vcampos4545/pen-plotter/README.md

# Pen Plotter

A local web app for sketching on a 2-axis pen plotter and sending the drawing to it
over WiFi. The plotter is an ESP32 running [FluidNC](https://github.com/bdring/FluidNC):
one NEMA 17 moves the paper tray, one moves the pen, and an MG90S servo on the Z axis
lifts the pen. The browser talks to FluidNC's WebSocket directly. Nothing is hosted
on the ESP32.

The controller's FluidNC `config.yaml`, wiring and first power-on steps are in
[firmware/README.md](firmware/README.md).

## Repository layout

- `src/`, `test/`, `sim/`, `index.html`: the web app, its tests and the FluidNC simulator.
- [`firmware/`](firmware/): FluidNC `config.yaml`, wiring and first power-on.
- [`hardware/`](hardware/): CAD source, printable STLs, KiCad project and fab orders.
- [`docs/`](docs/): bill of materials, wiring photos, assembly notes.

## Run it

Needs Node 20 or newer.

```sh
npm install
npm run dev        # serves the app at http://localhost:5173
npm test           # unit + simulator integration tests (Vitest)
npm run build      # typecheck and production build into dist/
```

## Using the app

- **Tools**: Pen (freehand), Line, Rect, Ellipse, Eraser (deletes a whole stroke),
  Undo/Redo, Clear. Shortcuts: `P` `L` `R` `O` `E`, Ctrl/Cmd+Z, Ctrl/Cmd+Shift+Z.
  Hold Shift for a square, a circle, or a line snapped to 15°.
- The sheet is drawn at its real aspect ratio. The dashed box is the margin; points
  are clamped to it while drawing. The red dot marks machine X0 Y0.
- The drawing is saved in localStorage on every change. Use **SVG** / **JSON** to
  export and **Import** to load them back. SVG import accepts `polyline`, `polygon`,
  `line` and straight-segment `path` elements; curves are rejected.
- **Topo** opens a world map for drawing contour lines or ridgelines of real terrain.
  See [Topo lines](#topo-lines) and [Ridgelines](#ridgelines) below.
- **Photo** turns a photo into lines: squiggles, a spiral, hatching, outlines or TSP
  art. See [Photo to lines](#photo-to-lines) below. Dropping a photo on the sheet
  opens it too.
- **Streets** draws roads, rivers and coastlines from OpenStreetMap for a box on the
  map. See [Street maps](#street-maps) below.
- **Generate** makes math art: spirographs, harmonographs, strange attractors, flow
  fields and mazes. See [Generate](#generate) below.
- **Text** draws lettering in single-stroke or outline fonts, filled, bent and
  shadowed. See [Text](#text) below.
- **Send to Plotter** runs flatten → simplify → optimize → G-code → stream. It is
  disabled unless the indicator says Connected and the drawing is inside the margin.
  **Download G-code** saves the same program to a file.
- The stats panel shows pen-up travel as drawn vs. after optimization. Tick
  **Show pen-up moves** to overlay the planned travel in red.
- **Job** shows lines sent and acknowledged and a percentage, with Pause, Resume and Stop.
- **Machine** has Unlock (`$X`), Pen up/down, To origin, Set origin, and a console for
  one-off commands. These are disabled while a job runs.
- **Set origin** makes the pen's current spot X0 Y0, after a confirmation. It clears the
  work offsets and runs `$H`, which with this repo's `config.yaml` sets the machine
  position of X and Y to 0 without moving (homing `cycle: -1`) and lifts the pen. The
  travel limits then count from the new origin too. With an older `config.yaml` it falls
  back to a work offset (`G10 L20`) and says how much of the travel window is left; see
  [firmware/README.md](firmware/README.md#set-origin).

### Topo lines

1. Press **Topo**. Pan and zoom the map to a place.
2. Press **Select area** (or hold Shift) and drag a box. The elevation for the box
   downloads and the contours appear in the preview on the right, in blue on top of
   the current drawing.
3. Adjust the controls. The preview updates without downloading again. **Style**
   switches between contour lines and [ridgelines](#ridgelines) on the same area.
   - **Contours**: a line every N metres, or N evenly spaced levels. When a new area
     would get fewer than 3 or more than 250 lines at the current interval, the
     interval is reset to a round number giving about 20.
   - **Smoothing**: blur passes over the elevation before contouring. More passes give
     calmer lines and fewer tiny loops.
   - **Simplify**: point reduction tolerance on the paper, in mm.
   - **Drop lines shorter than**: fragments below this length on the paper are left out
     so the plotter does not spend time on noise.
4. Press **Add to drawing**. The contours become ordinary strokes, added as one undo
   step, so undo, export, the planner, stats and Send treat them like anything drawn
   by hand.

Under the controls the dialog shows the elevation range, the line and point count, the
pen-down and pen-up distance and an estimate of the drawing time at the current feeds.

**Match paper shape** (on by default) locks the box to the shape of the drawable area,
measured on the ground, so the contours fill the sheet. Turn it off to select any
shape. The contours are always fitted inside the margin at the box's true proportions:
east-west distance is scaled by the cosine of the box's middle latitude, so a box far
from the equator is not stretched sideways. Large or very wide boxes leave unused paper
when the lock is off.

Elevation comes from the [AWS Terrain Tiles](https://registry.opendata.aws/terrain-tiles/)
(Terrarium PNG tiles, no key needed). The zoom level is chosen so the box's longer side
covers at least 400 source pixels, capped at 16 tiles per box and zoom 15. The elevation
is resampled to a grid of 300 samples on the box's longer side and contoured with
marching squares. A Topo session needs an internet connection; a failed download says
which tile failed and offers **Retry download**. An area with no contours at the chosen
settings (flat ground, or an interval larger than the elevation range) says so instead
of adding nothing silently.

The tested parts are `src/terrain.ts` (tile math, Terrarium decoding, stitching,
resampling, the aspect lock), `src/contour.ts` (smoothing, levels, marching squares)
and `src/topo.ts` (fitting to the paper and dropping fragments). `src/topo-ui.ts` is the
dialog and map wiring and loads only when **Topo** is first opened.

**Attribution.** The map's corner credits OpenStreetMap and the Terrain Tiles, and
**Elevation data sources** under the dialog's buttons holds the full terrain credit:

- Map tiles and data © [OpenStreetMap](https://www.openstreetmap.org/copyright)
  contributors.
- Elevation from the Terrain Tiles. Their
  [required attribution](https://github.com/tilezen/joerd/blob/master/docs/attribution.md)
  is: ArcticDEM terrain data DEM(s) were created from DigitalGlobe, Inc., imagery and
  funded under National Science Foundation awards 1043681, 1559691, and 1542736;
  Australia terrain data © Commonwealth of Australia (Geoscience Australia) 2017;
  Austria terrain data © offene Daten Österreichs, Digitales Geländemodell (DGM)
  Österreich; Canada terrain data contains information licensed under the Open
  Government Licence, Canada; Europe terrain data produced using Copernicus data and
  information funded by the European Union, EU-DEM layers; Global ETOPO1 terrain data
  U.S. National Oceanic and Atmospheric Administration; Mexico terrain data source:
  INEGI, Continental relief, 2016; New Zealand terrain data Copyright 2011 Crown
  copyright (c) Land Information New Zealand and the New Zealand Government (All rights
  reserved); Norway terrain data © Kartverket; United Kingdom terrain data ©
  Environment Agency copyright and/or database right 2015. All rights reserved; United
  States 3DEP (formerly NED) and global GMTED2010 and SRTM terrain data courtesy of the
  U.S. Geological Survey.

The map tiles come from `tile.openstreetmap.org`, which is fine for this kind of light
personal use under the [tile usage policy](https://operations.osmfoundation.org/policies/tiles/).

### Ridgelines

Stacked horizontal elevation profiles, like the *Unknown Pleasures* album cover but made
of real mountains.

1. Press **Topo**, select an area as for [Topo lines](#topo-lines), and set **Style** to
   **Ridgelines**. A box around one massif or a single valley reads best.
2. Adjust the controls. The preview updates live.
   - **Number of lines**: profiles drawn across the area, evenly spaced from its north
     edge (the back, at the top of the sheet) to its south edge (the front). 2 to 300,
     default 60.
   - **Height (line gaps)**: how far the highest point in the area rises above its own
     line, measured in gaps between lines. The status line shows what that means
     against the real ground, e.g. "heights about ×1.2 true scale".
   - **Flat baseline at the sides**: fades each profile down to a flat line over the
     outer 15% of the width on each side, for the album-cover look. Off, the profiles
     run edge to edge at their true elevation.
   - **Smoothing**, **Simplify** and **Drop lines shorter than** work as for contours;
     each style remembers its own values.
3. Press **Add to drawing**.

Hidden lines are removed: the profiles are drawn from the front of the area to the
back, and each one is cut where it passes behind the skyline of the rows in front of
it, so lines touch but never cross. A cut profile becomes separate strokes. Every
profile shares one horizontal scale, set by the box's ground width, so the map's
proportions hold across the sheet; the rows and the peaks of the back row are fitted
inside the margin together, which leaves a little unused paper at the sides when
**Match paper shape** is on. Simplify can move a line by up to its tolerance, so keep
it small.

The elevation is the same Terrain Tiles data as Topo lines, with the same attribution
(see above). The tested part is `src/ridgeline.ts` (layout, sampling, the skyline clip
and the options).

### Photo to lines

1. Press **Photo**, then **Choose photo…** or drop a JPEG, PNG or WebP on the dialog
   (or on the sheet). The image is decoded in the browser and never uploaded.
2. Pick a **Style** and **Framing**. **Crop to fill** cuts the photo to the shape of
   the drawable area so the lines fill the sheet; **Fit whole photo** keeps all of it
   and leaves margins. The thumbnail shows the photo as the generator sees it.
3. Adjust **Brightness**, **Contrast** and **Gamma** (above 1 lightens mid-tones), or
   tick **Invert**. Then tune the style:
   - **Squiggle lines**: rows across the sheet whose wave grows taller and tighter
     where the photo is darker. *Rows*, *Max amplitude* (× the row gap; 0.5 lets
     neighbouring rows touch) and *Frequency* (waves per mm at full black).
   - **Spiral**: one line from the centre out to the largest circle that fits, with a
     radial wobble in dark areas. The pen never lifts. *Ring spacing*, *Max amplitude*
     (× spacing) and *Frequency*.
   - **Hatching**: straight lines at *Line spacing* and *Angle*. Each of the 1 to 4
     *Layers* adds a direction (+90°, +45°, −45°) where the photo is darker than its
     threshold (evenly spaced, e.g. 25%, 50%, 75% for three layers).
   - **Outline**: Canny-style edge detection (blur, Sobel, thin edges, hysteresis)
     traced into lines. *Smoothing* blurs first, a higher *Edge threshold* keeps only
     strong edges, and *Drop lines shorter than* removes specks.
   - **TSP art**: *Points* stipples placed by darkness (weighted Lloyd relaxation),
     joined into one continuous path by a nearest-neighbour tour improved with 2-opt.
     *Time limit* caps stippling plus path optimization.
4. The preview shows the lines in blue on the sheet, with the line count, points,
   pen-down length, an approximate pen-up distance and draw time. A warning appears
   for jobs over 2 hours, drawings too big to autosave (over 200,000 points: export
   JSON to keep them) and more than 8,000 separate lines (slow path planning).
5. Press **Add to drawing**. The lines become ordinary strokes, added as one undo step.

Lines are generated in a Web Worker, so the dialog stays responsive while TSP runs.
The photo is scaled to at most 640 pixels on its longer side for processing. The
settings are remembered; the photo is not. The tested parts are `src/tone.ts`
(luminance, tone adjustments, sampling), `src/photo-styles.ts` (squiggle, spiral,
hatching), `src/edges.ts` (edge detection and tracing), `src/stipple.ts` (stippling,
tour and line ordering) and `src/photo.ts` (framing, options, the pipeline and the
estimate). `src/photo-ui.ts` is the dialog wiring and loads only when **Photo** is
first opened.

### Street maps

1. Press **Streets**. Pan and zoom the map to a place.
2. Press **Select area** (or hold Shift) and drag a box. **Match paper shape** works as
   in Topo. The roads, water and other features in the box download in one request and
   appear in the preview in blue.
3. Pick the **Layers**: major roads (motorway to tertiary), minor roads (residential,
   service, unclassified), paths (footways, cycleways, steps, tracks), railways (rail,
   light rail, tram; not yards or sidings), rivers and streams (centre lines), coast and
   water (coastlines and the outlines of lakes and rivers), buildings and parks.
   Buildings, parks and paths are off by default. Turning a layer off updates the
   preview at once; turning on one that was not downloaded shows **Download**, which
   fetches the box again with it.
4. Tune the lines. **Double-line major roads** draws each major road as two parallel
   lines **Double-line gap** mm apart so they read as wider. **Simplify** is the point
   reduction tolerance in mm, and **Drop lines shorter than** removes fragments left at
   the box edge.
5. Check the line count, pen-down length, pen-up estimate and draw time (with the same
   warnings as Photo), then press **Add to drawing**. The lines become ordinary
   strokes, added as one undo step.

The map is fitted inside the margin at its true ground proportions, the same way as
Topo. Every line is clipped to the selected box, not just the paper. OpenStreetMap
splits a street into many ways; ways that share an end node are joined into longer
lines (continuing along the straightest branch at junctions) so the pen lifts less.

The data comes from the public [Overpass API](https://wiki.openstreetmap.org/wiki/Overpass_API)
at `overpass-api.de`, which needs no key. To stay within its
[usage policy](https://wiki.openstreetmap.org/wiki/Overpass_API#Public_Overpass_API_instances), the
dialog sends exactly one request per box (or per **Download** / **Retry download**
press), never on layer or line changes, with a 90 s server time limit. Boxes are
capped by the densest layer you turn on: 3 km across with buildings, 5 km with paths,
8 km with minor roads, 15 km with parks and 25 km otherwise. A larger box is refused
with a message naming the layer to turn off. A busy server (HTTP 504), rate limiting
(HTTP 429), a timeout or a network failure says so and offers **Retry download**.

**Attribution.** Map data © [OpenStreetMap](https://www.openstreetmap.org/copyright)
contributors, available under the Open Database License. The credit is shown on the
map and under the dialog's buttons; keep it with plots you publish.

The tested parts are `src/osm.ts` (the Overpass query, tag classification, parsing the
reply, area limits and error messages) and `src/streets.ts` (projection, clipping,
joining, double lines and the pipeline). `src/map-select.ts` holds the box dragging
shared with Topo. `src/streets-ui.ts` and `src/osm-fetch.ts` are the dialog and the
request, and load only when **Streets** is first opened.

### Generate

1. Press **Generate** and pick a **Style**. The preview shows the lines in blue on the
   sheet, with the same line count, distance, draw-time estimate and warnings as Photo.
2. Tune it. **Size** is the share of the drawable area to use; every style is fitted
   inside the margin, centred, and curves keep their proportions. **Randomize** gives
   flow fields and mazes a new seed and the other styles new parameters. The same seed
   and settings always give the same drawing.
   - **Spirograph**: a wheel rolling inside (or, with *Roll outside the ring*, around)
     a fixed ring. *Ring teeth* and *Wheel teeth* are whole numbers, so the curve
     closes by itself after wheel ÷ gcd(ring, wheel) trips around the ring; the dialog
     says how many. *Pen offset* is the pen hole's distance from the wheel's centre
     (1 is the rim; above 1 draws loops).
   - **Harmonograph**: two pendulums swing the pen in X and Y while a third swings the
     paper in a circle, all dying away together. *Frequencies* near simple ratios (2:3,
     1:1) with a small detune (3.005) give the classic drifting figures. *Damping* is
     the share of the swing lost per second; drawing stops at *Duration* or once the
     swing is down to 3 %, whichever comes first.
   - **Lorenz**: the Lorenz system (σ, ρ, β) integrated with RK4 in steps of 0.005 and
     projected flat. *View angle* turns it about its vertical axis and *Tilt* looks
     down on it. One continuous line.
   - **Clifford** and **De Jong**: 2D attractor maps with five presets each plus
     manual *a*, *b*, *c*, *d*. Their orbits jump across the whole shape on every
     step, so joining the dots draws random chords and dotting them needs a pen lift
     per point. Instead a tiny segment on the attractor is pushed through the map again
     and again, refilling any gap wider than 1/1000 of the shape after each pass. That
     is drawn as **one continuous line** that traces the attractor's filaments.
     *Density* is its length in multiples of the attractor's size. Parameters that
     settle to a point or a short cycle say so.
   - **Flow field**: evenly spaced streamlines (Jobard and Lefer) through a seeded
     Perlin noise field. *Swirl size* is the noise scale, *Curl* how far lines turn.
     Lines are traced both ways from a seed and stop at the edge, at *Longest line*,
     or within half the *Line spacing* of another line or of themselves, so they never
     pile up. New lines start one spacing beside finished ones, then from a shuffled
     grid to fill holes. *Step* is the integration step.
   - **Maze**: a perfect maze (recursive backtracker; exactly one route between any two
     cells) of as many *Corridor width* cells as fit. Walls are merged into straight
     runs and the runs chained end to end, so a 47 × 47 maze plots as about 400 lines.
     The entrance is at the top left and the exit at the bottom right. *Draw the
     solution* adds the route as its own stroke.
3. Press **Add to drawing**. The lines become ordinary strokes, added as one undo step.

Lines are generated in a Web Worker, so the dialog stays responsive. The settings are
remembered. The tested parts are `src/noise.ts` (seeded Perlin noise),
`src/curves.ts` (spirograph and harmonograph), `src/attractor.ts` (Lorenz, the 2D maps,
presets and random chaotic parameters), `src/flowfield.ts` (streamlines and
separation), `src/maze.ts` (generation, solving, wall merging) and `src/generate.ts`
(options, fitting, the pipeline and Randomize). `src/generate-ui.ts` is the dialog
wiring and loads only when **Generate** is first opened.

### Text

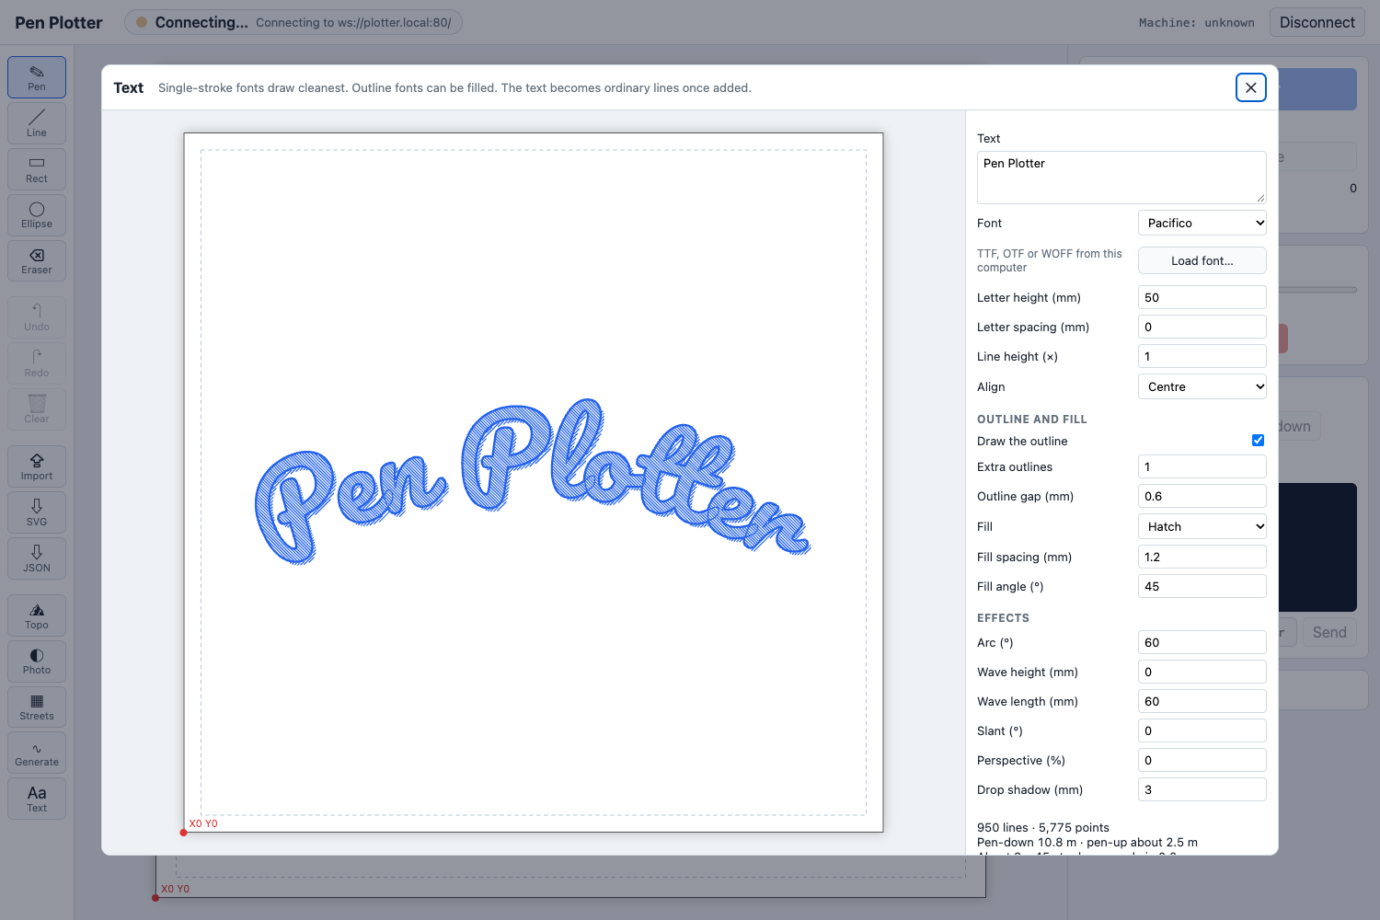
[picture p1: docs/images/text-tool.png]
The Text dialog: Pacifico on an arc, hatched, with an extra outline and a drop shadow


1. Press **Text** and type. New lines in the box start new lines of text. The preview,
   estimate and warnings work as in Generate.
2. Pick a **Font**. *Single-stroke* fonts are seven Hershey fonts (sans, sans bold,
   serif, serif italic, script, cursive, gothic): each letter is a few pen strokes,
   which is what a plotter draws best. *Outline* fonts are Bebas Neue, Abril Fatface,
   Bungee and Pacifico, or **Load font…** for a TTF, OTF or WOFF on this computer
   (kept for this visit only). **Letter height** is the height of a capital in mm.
   *Letter spacing*, *Line height* and *Align* set out the block.
3. Style it:
   - Single-stroke fonts: *Extra passes each side* draws parallel copies of every
     stroke, *Pass gap* apart, for a heavier line.
   - Outline fonts: *Draw the outline*, plus *Extra outlines* grown outwards by the
     *Outline gap* for a bold or double outline. *Fill* is none, hatch, crosshatch,
     inset rings (the outline repeated inwards), wavy lines, a spiral, or a flow field,
     all *Fill spacing* apart; hatch and wavy lines run at *Fill angle*. Fills follow
     the font's own nonzero rule, so the holes in letters like O and A stay empty.
   - Effects, for either kind: *Arc* bends the text round a circle (degrees of arc for
     the widest line; negative curves down), *Wave height* and *Wave length* make it
     ripple, *Slant* leans it, *Perspective* grows the letters along the line, and
     *Drop shadow* adds a hatched shadow down and to the right that stops short of
     the letters.
4. Press **Add to drawing**. The text becomes ordinary strokes, added as one undo step,
   and can't be edited as text afterwards.

The block is centred in the drawable area and shrunk to fit if it is too big; the
dialog says by how much. Layout runs in a Web Worker. The settings are remembered; a
loaded font file is not. The tested parts are `src/hershey.ts` (the Hershey `.jhf`
format), `src/outline-font.ts` (opentype.js glyphs to contours), `src/text-layout.ts`
(layout and the bends), `src/text-fill.ts` (exact hatching, the signed distance field
behind insets, extra outlines and clipping, stroke offsets) and `src/text.ts` (options
and the pipeline). Font data and licences are in [`src/fonts/`](src/fonts/).
`src/text-ui.ts` is the dialog wiring and loads only when **Text** is first opened.

### Connection indicator

| State | Meaning |
| --- | --- |
| Disconnected | Not trying to connect (you pressed Disconnect). |
| Connecting | Socket opening, or open but no recent reply to `?`. |
| Connected | Socket open and FluidNC answered a `?` status query in the last 2.5 s. |
| Streaming | A job is running (Paused / Stopping / Interrupted / Resuming shown next to it). |
| Error | The socket failed or FluidNC stopped answering. Retries with backoff (1 s doubling to 15 s). |

The app polls `?` every 500 ms and shows the machine state and position in the top bar
and as a green crosshair on the sheet.

## Point it at the plotter

Open **Settings** and set:

- **Host**: defaults to `plotter.local`. FluidNC's default hostname is `fluidnc`, so
  either run `$Hostname=plotter` on the controller once (then restart it; see
  [firmware/README.md](firmware/README.md#wifi-and-hostname)) or type its current name
  or IP address here.
- **WebSocket port**: `80` for FluidNC v4.x (the current release line). Use `81` for v3.x.
- **WebSocket path**: `/`.

Settings are saved in localStorage. Changing host, port or path reconnects.

Other settings: paper width/height and margin (default 400 × 400 mm, 10 mm margin),
which paper corner is machine X0 Y0 (default bottom-left), pen up/down Z (default Z5 / Z0),
dwell after each pen move (default 0.15 s), draw and travel feeds, freehand
simplification tolerance (default 0.2 mm), endpoint-join tolerance, the optimizer
time limit, and how many lines may be in flight.

## What FluidNC's WebSocket looks like

Checked against the FluidNC source (`FluidNC/src/WebUI/WebUIServer.cpp` and
`WSChannel.cpp`) at release v4.1.1 and `main` in October 2026, and against v3.9.9:

- **Port and path.** v4.x moved to ESPAsyncWebServer and registers the socket as
  `AsyncWebSocket("/")` on the HTTP server, so it is `ws://<host>:80/` (it follows the
  `HTTP/Port` setting, `$HTTP/Port`). v3.x ran separate `WebSocketsServer`s on HTTP
  port + 1 (`81`, used by WebUI v2) and + 2 (`82`, subprotocol `webui-v3`).
- **Client to FluidNC.** Text or binary frames are fed byte by byte into the same channel
  as serial. Realtime characters (`?`, `!`, `~`, `0x18`) act immediately wherever they
  appear. Everything else is buffered until `\n`. A text frame that starts with
  `PING:` is answered by the WebUI keepalive and not treated as input. The app sends one
  line per frame and each realtime character as its own frame.
- **FluidNC to client.** Console output (`ok`, `error:N`, `ALARM:N`, `<...>` status
  reports, `[MSG:...]`) arrives as **binary** frames of plain text. Output is
  coalesced: one frame can hold several lines or end mid-line (flush at ~1400 bytes or
  after 8 ms idle), so the app reassembles lines across frames. WebUI bookkeeping
  arrives as short **text** frames such as `currentID:3` and `CURRENT_ID:3`, which the
  app ignores.
- **Auto reports.** v4 turns on automatic status reports for WebSocket channels (200 ms
  interval). The app still polls `?` and treats either kind of report as a reply.
- **Sessions.** In v4 a new socket closes older sockets from the same browser session
  (the session cookie, or empty without one). Keep only one tab of this app open. If you
  need several independent clients, adding `?independent_session` to the path gives
  each socket its own session.

## Streaming and stopping

- Lines are streamed with ok-counting flow control. At most **Lines in flight**
  (default 4) are unacknowledged. Each `ok` releases the next line. The job is never
  sent as one message.
- When every line is acknowledged the job is "finishing moves" until FluidNC reports Idle.
- **Pause** sends `!` (feed hold) and stops sending. **Resume** sends `~`.
- **Stop** sends a soft reset (`0x18`). A reset during motion leaves FluidNC in Alarm,
  so once the startup banner comes back (or after 2.5 s) the app sends `$X` and then
  `G21 G90 G0 Z<pen up>` to lift the pen.
- An `error:` or `ALARM:` reply during a job aborts it with the same sequence and shows
  the failing line.
- If the socket drops mid-job, the job is **not** failed. FluidNC keeps running the
  moves it had already queued (its planner is not held when a WebSocket client goes
  away; only that client's unparsed input is dropped). The job shows **Reconnecting**
  for 30 s and then **Interrupted**, while the connection retries on its own. Once the
  plotter is back, press **Resume**:
  1. The app waits for the machine to finish its buffered moves (a held machine gets
     `~` first) and reach Idle.
  2. Every line that got an `ok` ran. Of the lines sent but not acknowledged, some
     prefix may have arrived and run. The app picks the one whose end point matches
     where the pen is now (X/Y, 0.05 mm). If several match, it takes the earliest, so
     it may redraw a short piece but never skips one.
  3. It sends `G21 G90`, pen up, travel to the last point, puts the pen back at the
     program's height, restores the feed, and continues from the next line.
  It refuses to resume, and says why, if the machine is in Alarm, if the controller
  restarted (its banner arrives, or the position matches no candidate line, which is
  what a reboot or lost steps look like), or if it is in Door, Sleep or Check. Stop
  while the link is down just abandons the job; once connected it soft-resets as usual.
  A job that finished during the drop is marked done. The logic is `src/resume.ts`
  and the `reconnecting` / `interrupted` / `resyncing` states in `src/streamer.ts`.

## Troubleshooting: the connection drops mid-job

The console logs every connection change with a time and the WebSocket close code,
and on a mid-job drop it prints the lines around where the job was. That is enough to
tell the causes below apart on the next run.

**What FluidNC does (from the v4.1.1 source).** FluidNC closes a WebSocket client
itself if its outgoing queue fills **while the machine is moving**
(`WSChannel::send_frame`: in a motion state it does not wait, and a failed send with a
full queue calls `client->close()`). The queue holds `WS_MAX_QUEUED_MESSAGES` = 8
frames, and frames only pile up when the ESP32 cannot hand data to TCP, i.e. while
the browser is not acknowledging it: a WiFi stall, retries or interference. When idle,
FluidNC defers the output instead of closing, so a flaky link looks healthy until a job
runs. During a job the outgoing frames are one per `ok` (FluidNC flushes output after
8 ms idle, so `ok`s more than 8 ms apart are separate frames) plus status reports (5/s
auto-reports, and 2/s more from the app's `?` poll). Generated jobs vary a lot in line
rate: on the Generate styles the densest second runs about 2 to 4 times the median
(e.g. 27 to 36 lines/s against 7 to 15), so the same stretch of a drawing can be the
place where a short stall tips the queue over.

**Telling the causes apart.**

| Console shows | Likely cause |
| --- | --- |
| `Connection closed (code 1005)`, reconnects within a second or two, Resume finds the position | FluidNC closed the socket with a close frame: send queue full during motion, or another tab of this app (or the FluidNC WebUI) opened a socket in the same browser session. |
| `Connection closed (code 1006)`, reconnects quickly, Resume finds the position | The TCP connection died without a close frame: a WiFi drop, or FluidNC's close that never got through a stalled link. |
| `No status reply from FluidNC` | Nothing arrived for 5 s: the link stalled or the ESP32 stopped answering. |
| Resume says the position matches no line, the pen dropped, or the position reads X0 Y0 where it should not | The ESP32 rebooted, most likely a brownout. Reconnecting also takes longer (boot plus WiFi join). |

**Things to try, cheapest first.**

1. Run the same drawing again with the browser tab in front and the Mac on power, and
   note the console lines at the drop. If it drops at the same line number again, that
   points at content (dense segments), not at random WiFi loss.
2. Capture FluidNC's own log: connect USB, open a serial terminal at 115200, run
   `$Message/Level=Debug`, then start the job over WiFi. Look for `Websocket queue full
   while sending to cid#…`, `WebSocket disconnect cid#…` or `backlog … closing`. A
   reboot prints the ESP32 boot log instead, with `Brownout detector was triggered` if
   it was the supply. `$SS` shows the startup log after a reboot.
3. Check `$WiFi/PsMode` is `None` (the v4.1.1 default). Modem sleep delays delivery.
4. Improve the link: move the plotter or the access point, use a 2.4 GHz network with
   less traffic, or give the ESP32 an external antenna.
5. Fewer frames while drawing: lower **Lines in flight** (fewer `ok`s outstanding), or
   send `$RI=1000` from the console after connecting to slow FluidNC's auto-reports on
   this socket from 200 ms to 1 s (it resets on every new connection).
6. If it is a brownout: check the buck converter holds 5.0 V under load (servo moving,
   both motors running), add a few hundred µF at the ESP32's 5 V input and at the servo,
   or power the servo from its own regulator.

## Path planning and G-code

Planning is in `src/planner.ts` and G-code generation is in `src/gcode.ts`. Both are pure
and unit tested. The pipeline is `buildJob` in `src/job.ts`.

1. Freehand strokes are simplified with Ramer-Douglas-Peucker. Ellipses are flattened
   to chords within 0.05 mm.
2. Paper coordinates (origin top-left, Y down) are mapped to machine coordinates. With
   the default bottom-left origin, Y is flipped.
3. Every point must lie inside the paper minus the margin. Otherwise nothing is
   generated or sent.
4. Strokes whose endpoints touch (within the join tolerance) are merged so the pen stays down.
5. Greedy nearest neighbor from X0 Y0 picks each next stroke and its direction. Then a
   2-opt pass with stroke reversal improves the order until it converges or hits the
   time limit (default 1 s).
6. G-code: `G21 G90`, pen up, then per stroke `G0` to the start, pen down,
   `G1 ... F<draw feed>`, pen up. It ends with `G0 X0 Y0`. Every pen change is a `G0 Z`
   move followed by `G4 P<dwell>`.

FluidNC runs `G0` at each axis' `max_rate_mm_per_min` and ignores `F`. So **Travel feed**
only matters for the time estimate, unless you enable **Pen-up moves as G1 at travel
feed**, which emits travel as `G1 ... F<travel feed>`.

## Simulator

`npm run sim` starts a mock FluidNC WebSocket server at `ws://127.0.0.1:8081/`. To use it,
set Host `127.0.0.1`, Port `8081` and Path `/` in Settings.

```sh
npm run sim                             # defaults: port 8081, 20x faster than real time
npm run sim -- --port 9000 --speedup 5  # slower, easier to watch pause/stop
SIM_VERBOSE=1 npm run sim               # log every received line
```

It mimics the parts of FluidNC the app relies on: binary output frames coalesced like
the firmware, `currentID` text frames on connect, `?` status reports with live position,
`!` / `~` hold and resume, and `0x18` soft reset (`ALARM:3` if it interrupts motion, then
the banner). It acks each line with `ok` when its simulated move finishes. Malformed or
unsupported lines get `error:N`, G-code in Alarm gets `error:9`, and it supports `$X`.
It keeps a work offset (`G10 L2`/`L20`, `G92.1`, `WCO` in every tenth report), and `$H`
sets X/Y to machine 0 and lifts the pen like the repo's config. `--home-xy false` models
an older config where `$H` only lifts the pen.

`test/sim.integration.test.ts` runs the real connection and streamer against it: the
connected handshake, a full job under flow control, pause/resume, stop with pen lift,
abort on `error:`, Set origin with both configs, reconnect after the server restarts,
and a socket dropped mid-job then resumed (checking every segment is drawn once). Like
FluidNC, the mock keeps running lines a dropped client already sent.

## Not done yet

Limit switches and homing (the config has the steps for adding them), hosting the app
on the ESP32, multiple pens or widths, colour separation, and SVG curve import.
