vcampos4545/pen-plotter/docs/README.md

# Docs

Build notes that are not code.

- [`bom.md`](bom.md): bill of materials.
- Wiring photos and assembly notes go here too. Name photos by what they show
  (`wiring-drivers.jpg`), and keep each under ~1 MB.

Wiring diagrams and pin maps live in [`../firmware/README.md`](../firmware/README.md).
