vcampos4545/pen-plotter/hardware/cad/PenPlotter.step

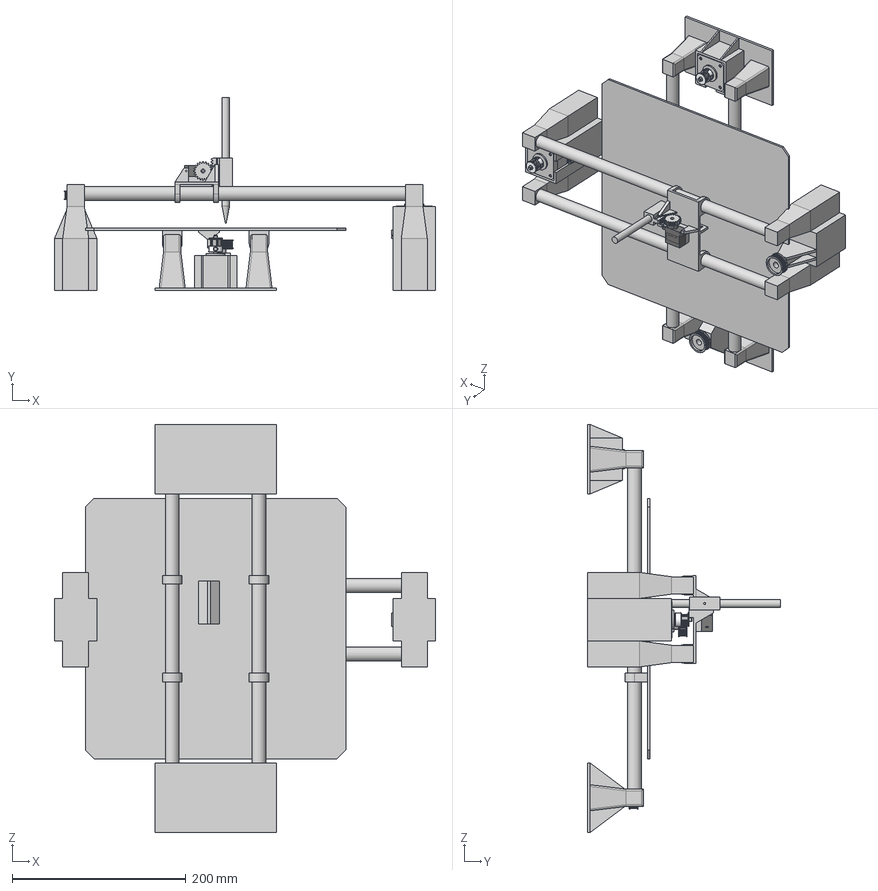
[picture p2: CAD file, 2026-10-28]
hardware/cad/PenPlotter.step
438.9 x 222.6 x 470.0 mm
STEPPERONLINE_Nema17_Stepper_Motor x 2
Gear-5mm-20 teeth x 2
Axe
base001
