vcampos4545/pen-plotter/(commit log)

2026-10-09 Add pen plotter sketch app with FluidNC streaming
    Vite + TypeScript web app for drawing on a 400x400 mm sheet and sending
    the drawing to an ESP32 running FluidNC over its WebSocket.
    - Drawing tools: freehand, line, rect, ellipse, stroke eraser, undo/redo,
    clear, SVG/JSON import and export, localStorage persistence.
    - Planning: RDP simplification, endpoint merging, greedy nearest neighbor
    plus time-capped 2-opt with stroke reversal, bounds checks.
    - G-code for FluidNC: absolute mm, servo pen on Z with dwell, G0 travel,
    G1 drawing, ends pen up at the origin.
    - Connection indicator backed by ? status polling, auto-reconnect with
    backoff, ok-counted line streaming with pause, resume and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
2026-10-10 Add FluidNC config and wiring guide for the plotter
    firmware/config.yaml targets FluidNC v4.1.1: X pen carriage and Y paper
    tray on two TMC2209s sharing UART1 (addresses 0 and 1), 80 steps/mm,
    400 mm soft limits, and the MG90S pen-lift servo on Z mapped so Z0 is
    pen down and Z5 is pen up, matching the app's defaults. Validated with
    FluidNC's tools/validate_fluidnc_config.py.
    firmware/README.md covers flashing, WiFi and hostname settings, wiring,
    power, setting motor current, and a first power-on checklist.
2026-10-10 Set motor current for the 17HE15-1504S steppers
    Both axes now run at 1.0 A RMS (about 70% of the 1.5 A rating) and hold
    at 0.5 A. The guide's current section leads with this motor and keeps
    the procedure for an unknown motor.
2026-10-24 Add Topo: contour lines from a box on a world map
    A Leaflet/OpenStreetMap dialog lets you drag a box (locked to the paper's
    shape by default). Elevation comes from the AWS Terrain Tiles (Terrarium),
    with the zoom picked from the box size and capped at 16 tiles. The grid is
    resampled, optionally blurred, contoured with marching squares, fitted inside
    the margin at the box's true ground proportions, simplified, and stripped of
    short fragments. The result is previewed and added as ordinary strokes in one
    undo step.
    Pure logic lives in src/terrain.ts, src/contour.ts and src/topo.ts with
    Vitest coverage; tests use a fake tile loader and never hit the network.
2026-10-25 Add Ridgelines: stacked elevation profiles with hidden lines removed, as a Topo style
    A Style select in the Topo dialog switches the same map box and elevation
    download between contour lines and ridgelines. Profiles are drawn front to
    back and clipped against the running skyline so they never cross. Controls
    for line count, height in line gaps, a flat-baseline edge fade, smoothing,
    simplify and a length filter. Both styles now show pen distance and a
    draw-time estimate. Pure logic and tests in src/ridgeline.ts.
2026-10-25 Add Streets: roads, rivers and coastlines from OpenStreetMap for a box on the map
    Drag a box on a Leaflet map and download its features from the public
    Overpass API in one request: major and minor roads, paths, railways,
    rivers, coast and water outlines, buildings and parks as toggleable
    layers. Ways that share end nodes are joined so the pen lifts less,
    every line is clipped to the box, short fragments are dropped, and
    major roads can be drawn as a parallel double line. Boxes are capped
    by the densest chosen layer, and 429/504/timeouts say so and offer a
    retry. The preview shows line count, pen distance and draw time.
    The box dragging moves out of topo-ui.ts into map-select.ts so both
    map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
2026-10-25 Add Generate: spirographs, harmonographs, strange attractors, flow fields and mazes
    A Generate dialog with a style picker, live preview, line count, pen
    distance and draw-time estimate, a Size control that fits every style
    inside the margin, and Randomize (a new seed for flow fields and mazes,
    new parameters for the rest). Generation runs in a Web Worker.
    - Spirograph: hypotrochoid or epitrochoid from whole tooth counts,
    closing exactly after wheel / gcd(ring, wheel) trips.
    - Harmonograph: two lateral pendulums plus a rotary one, damped,
    stopping when the swing is down to 3%.
    - Lorenz (RK4, view angle and tilt), Clifford and De Jong with presets
    and manual a/b/c/d. The 2D maps are dra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
2026-10-28 Add Set origin: make the pen's spot X0 Y0 and move the soft limits with it
    The Machine panel gets a Set origin button (confirmed, disabled during a job)
    that sends G10 L2 P0 X0 Y0, G92.1 and $H. config.yaml gives X/Y homing
    cycle -1, so $H sets their machine position to 0 in place, and the Z servo
    cycle that follows resyncs FluidNC's parser and planner. With an older
    config the app sees MPos unchanged, falls back to G10 L20 and reports the
    travel window that is left. The sequence lives in src/origin.ts with unit
    tests; the simulator models offsets and $H for both configs.
2026-10-28 Invert Y direction in config.yaml: +Y ran backwards
    direction_pin for Y is now gpio.32:low. The first power-on checklist says
    Y is inverted by default and how to flip it back. Re-upload config.yaml
    and restart the controller for it to take effect.
    [config.yaml]
2026-10-28 Add hardware/ and docs/ layout with READMEs, BOM, gitattributes and KiCad/CAD ignores (#1)
2026-10-28 Add PenPlotter.step
    [PenPlotter.step]
2026-10-28 Add PenPlotter KiCad project to hardware/pcb (#2)
    [PenPlotter.kicad_pcb, PenPlotter.kicad_sch]
2026-10-29 Add Text tool: Hershey and outline fonts, fills, arc/wave/slant/perspective and drop shadow (#3)
    A new generator dialog lays out multi-line text and adds it to the drawing as
    ordinary strokes. Single-stroke Hershey fonts (seven styles) can be thickened
    with parallel passes. Outline fonts (Bebas Neue, Abril Fatface, Bungee,
    Pacifico, or a TTF/OTF/WOFF from disk, parsed with opentype.js 1.3.4) can be
    outlined, given extra outlines and filled with hatch, crosshatch, inset rings,
    wavy lines, a spiral or a flow field. Fills follow the nonzero rule so counters
    stay empty. Effects: arc, wave, slant, perspective and a hatched drop shadow.
    Pure geometry is in hershey.ts, outline-font.ts, text-layout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
2026-11-12 Resume a job after the connection drops mid-job (#4)
    A WebSocket drop no longer fails the job. FluidNC keeps running the moves
    it had queued, so the job goes to Reconnecting (30 s grace) and then
    Interrupted while the connection retries. Resume waits for the machine to
    reach Idle, works out from its position which line it stopped after
    (between the last acked and last sent line, earliest match wins), lifts the
    pen, travels back, restores pen height and feed, and continues from the
    next line. It refuses in Alarm, after a controller restart, or when the
    position matches no candidate line.
    Also log connection changes with time and close code, and the lines around
    a mid-job drop, and document t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
